mutezvaprince-png/WATER-TANK-AUTOMATION-NEW/hardware/cad/README.md

# CAD files (SolidWorks 2022, millimetres)

Put the final files here:

| File | Part |
| --- | --- |
| `THE TANK.SLDPRT` | Tank, 206 x 206 x 303 mm outside, 3 mm walls, open top |
| `THE LID.SLDPRT` | Lid with locating rim, sensor frame, cable slot, inlet hole |
| `HOSE ADAPTER.SLDPRT` | Flange with 10 mm neck and 6 mm bore |
| `Enclosure.SLDPRT` | Electronics enclosure |
| `Cover.SLDPRT` | Enclosure cover |
| `PumpBracket.SLDPRT` | Pump bracket |
| `Assem1.SLDASM` | Assembly of all six parts |

Keep all files in this one folder so the assembly can find its parts.
