mutezvaprince-png/WATER-TANK-AUTOMATION-NEW/hardware/stl/README.md

# STL files for 3D printing

Export each part from SolidWorks (File, Save As, STL) and put the six files here:
tank, lid, hose adapter, enclosure, cover, pump bracket.
Print the tank upright as one piece. See `docs/Technical_Report.docx`, section 7, for print settings.
