mutezvaprince-png/WATER-TANK-AUTOMATION-NEW/docs/images/Simulation2.png

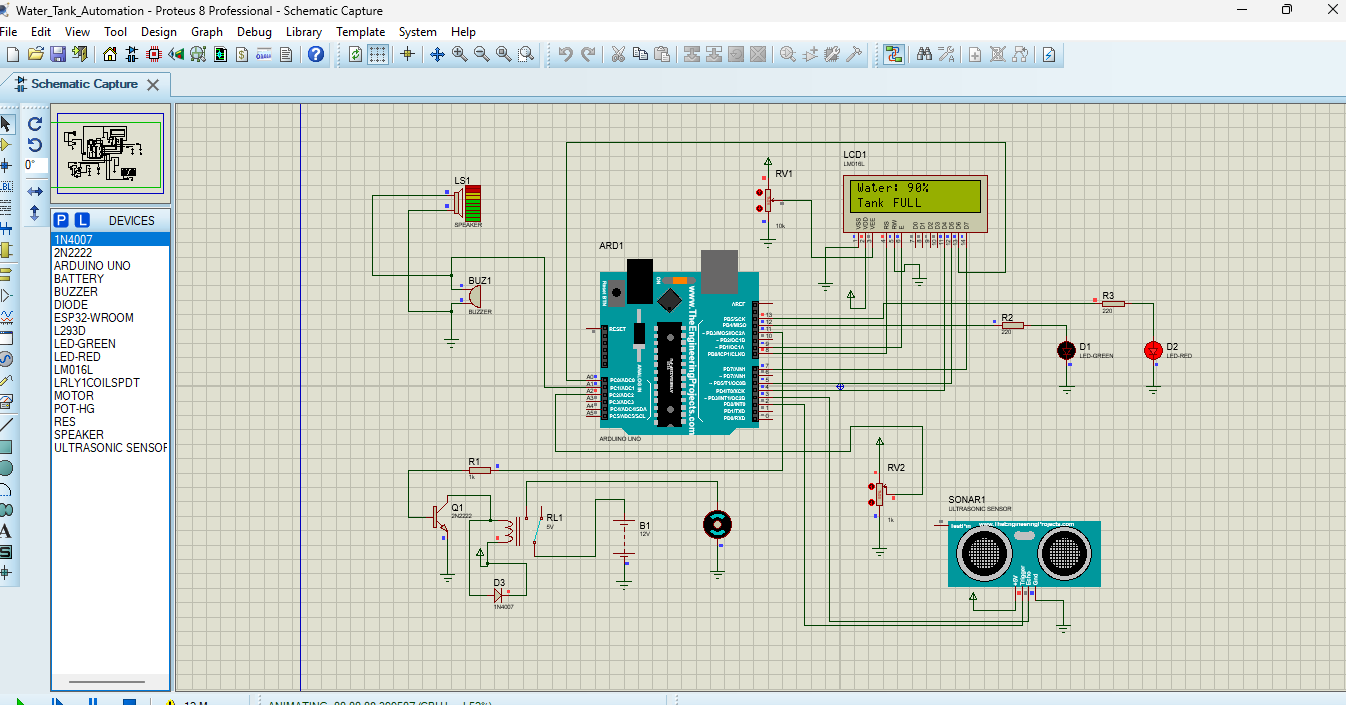
docs/images/Simulation2.png
