mutezvaprince-png/WATER-TANK-AUTOMATION-NEW/hardware/cad/Assem1.SLDASM

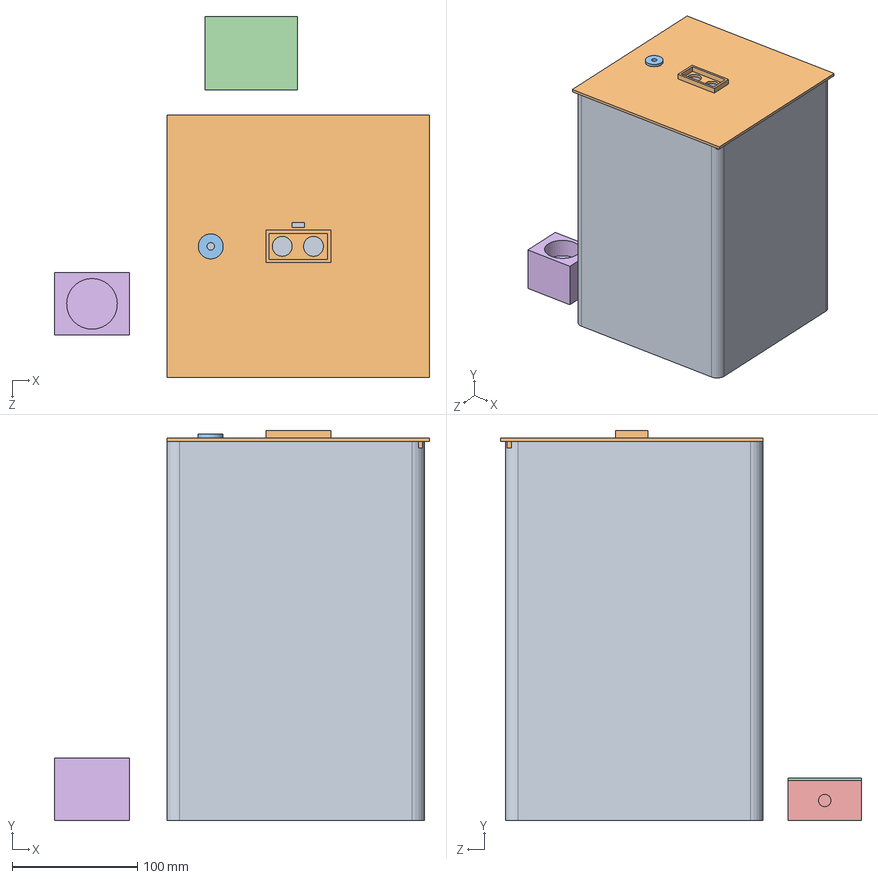
[picture p18: CAD file, 2026-10-10]
hardware/cad/Assem1.SLDASM
300.0 x 312.0 x 289.0 mm
THE TANK
THE LID
HOSE ADAPTER
Cover
Enclosure
PumpBracket
