mutezvaprince-png/WATER-TANK-AUTOMATION-NEW/hardware/cad/Cover.SLDPRT

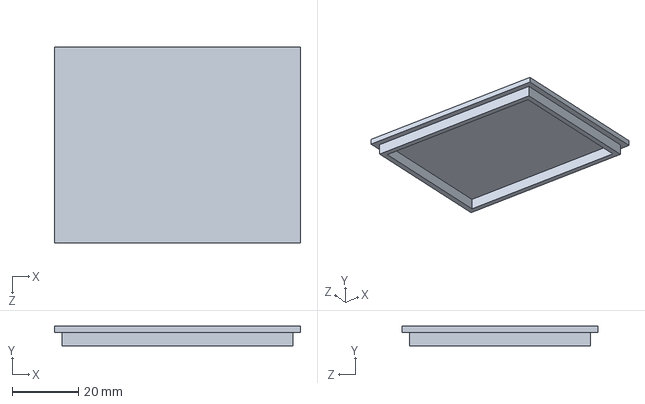
[picture p19: CAD file, 2026-10-10]
hardware/cad/Cover.SLDPRT
74.0 x 6.00 x 59.0 mm
