mutezvaprince-png/WATER-TANK-AUTOMATION-NEW/hardware/cad/THE LID.SLDPRT

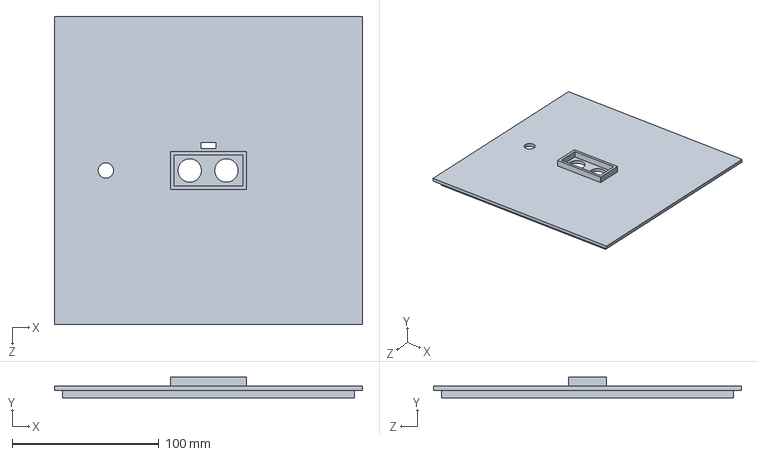
[picture p20: CAD file, 2026-10-10]
hardware/cad/THE LID.SLDPRT
210.0 x 14.0 x 210.0 mm
