mutezvaprince-png/WATER-TANK-AUTOMATION-NEW/hardware/cad/PumpBracket.SLDPRT

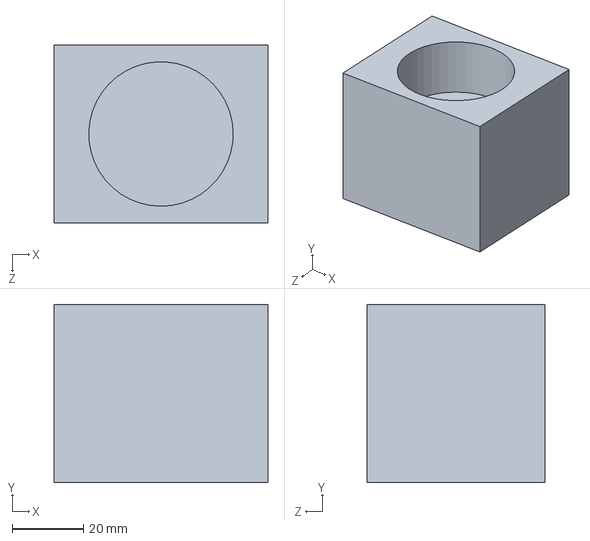
[picture p21: CAD file, 2026-10-10]
hardware/cad/PumpBracket.SLDPRT
60.0 x 50.0 x 50.0 mm
