mutezvaprince-png/WATER-TANK-AUTOMATION-NEW/hardware/cad/HOSE ADAPTER.SLDPRT

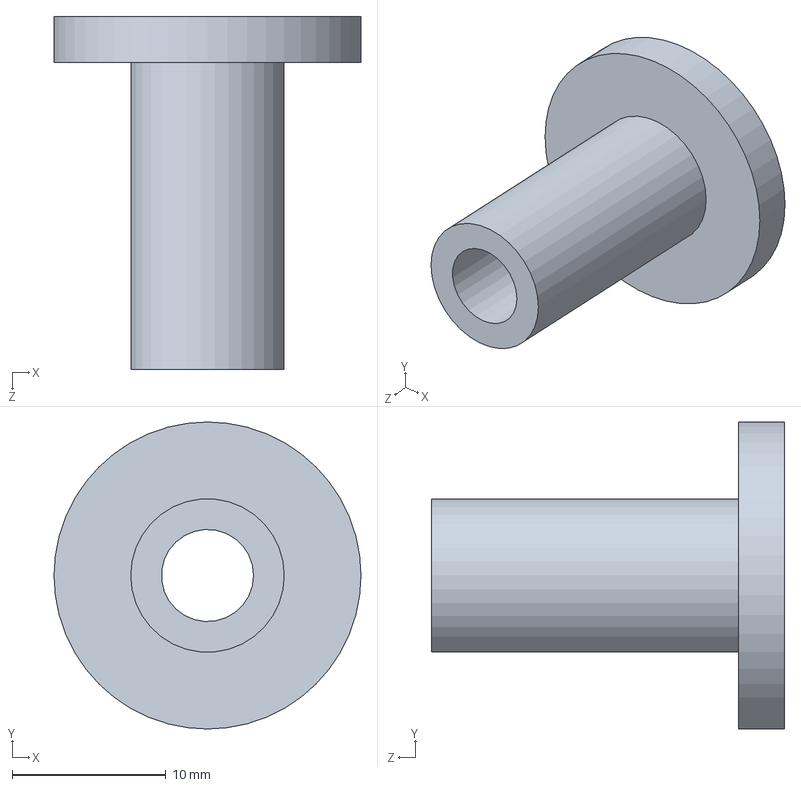
[picture p22: CAD file, 2026-10-10]
hardware/cad/HOSE ADAPTER.SLDPRT
20.0 x 20.0 x 23.0 mm
