mutezvaprince-png/WATER-TANK-AUTOMATION-NEW/hardware/cad/THE TANK.SLDPRT

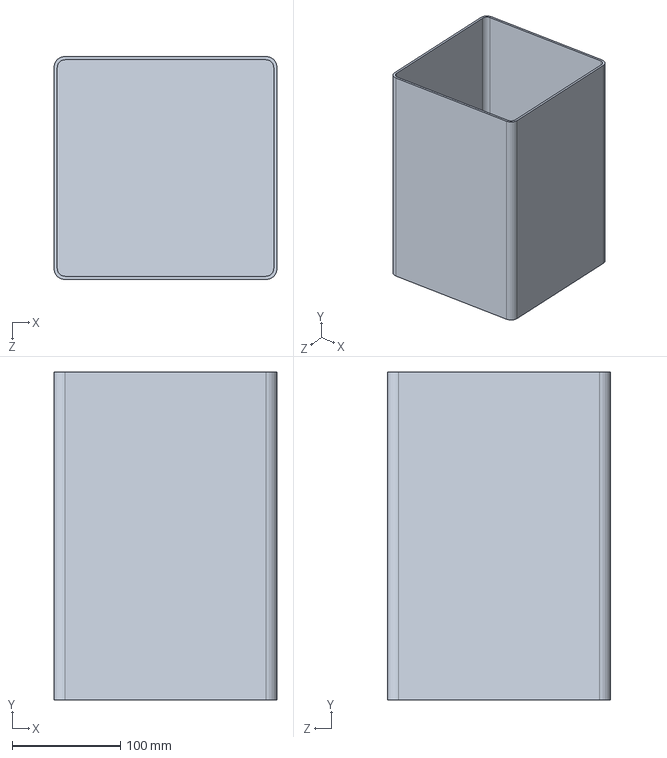
[picture p23: CAD file, 2026-10-10]
hardware/cad/THE TANK.SLDPRT
206.0 x 303.0 x 206.0 mm
