mutezvaprince-png/WATER-TANK-AUTOMATION-NEW/hardware/cad/Enclosure.SLDPRT

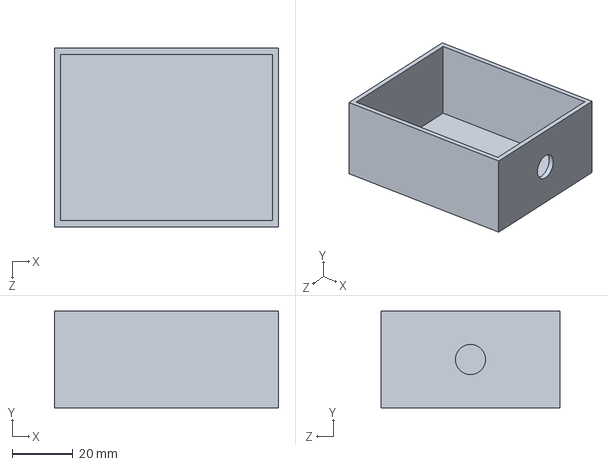
[picture p24: CAD file, 2026-10-10]
hardware/cad/Enclosure.SLDPRT
74.0 x 32.0 x 59.0 mm
