mutezvaprince-png/WATER-TANK-AUTOMATION-NEW/(list of files, cad)

Other CAD files:
hardware/stl/Cover.STL
hardware/stl/Enclosure.STL
hardware/stl/HOSE ADAPTER.STL
hardware/stl/PumpBracket.STL
hardware/stl/THE LID.STL
hardware/stl/THE TANK.STL
