mutezvaprince-png/WATER-TANK-AUTOMATION-NEW/(list of files, drawings)

Other design files:
simulation/Water_Tank_Automation.pdsprj
